nitish-nagesh/contactless-trash-weight-estimator/pictures/IndoorFoodTrash.jpeg

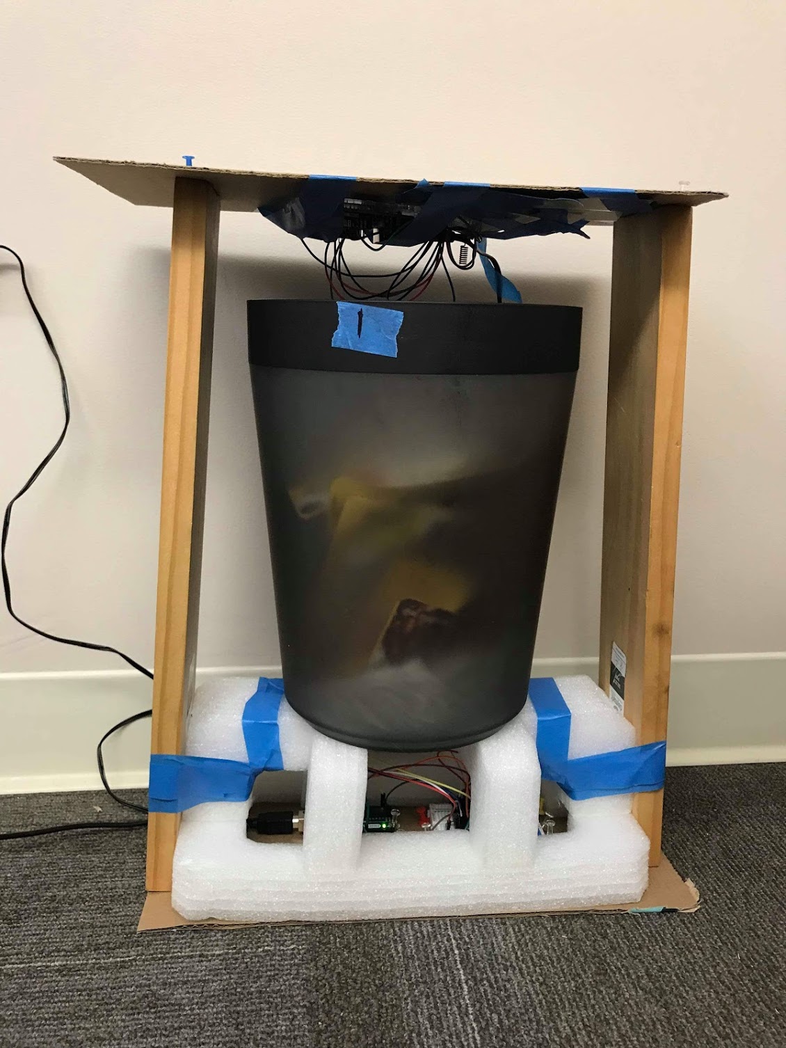
pictures/IndoorFoodTrash.jpeg
