nitish-nagesh/contactless-trash-weight-estimator/pictures/client_server.jpeg

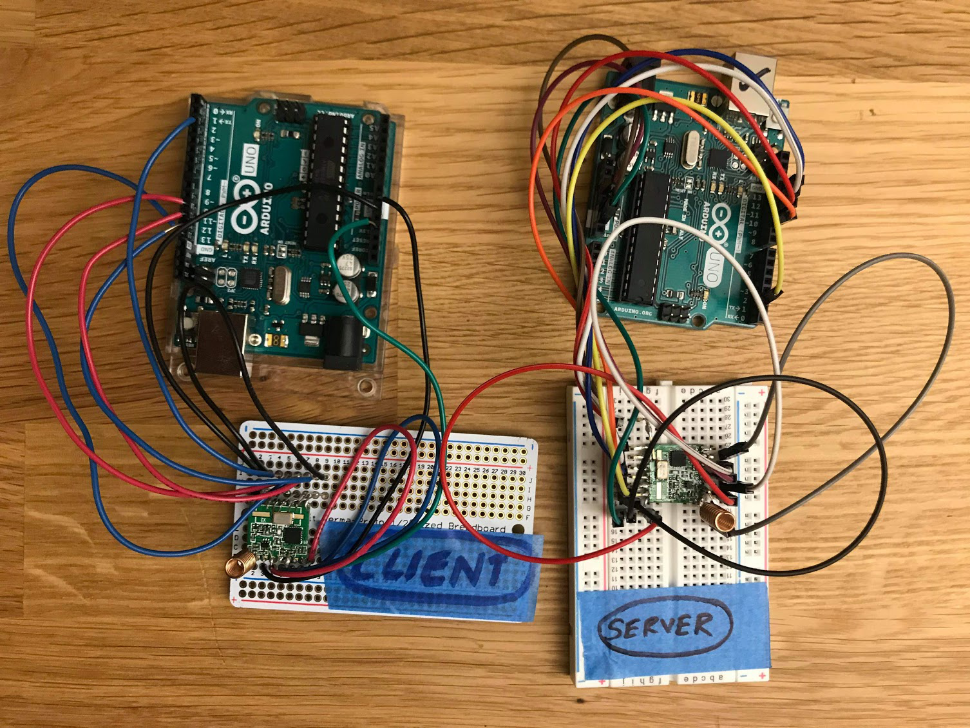
pictures/client_server.jpeg
