nitish-nagesh/contactless-trash-weight-estimator/pictures/FoodWaste.jpeg

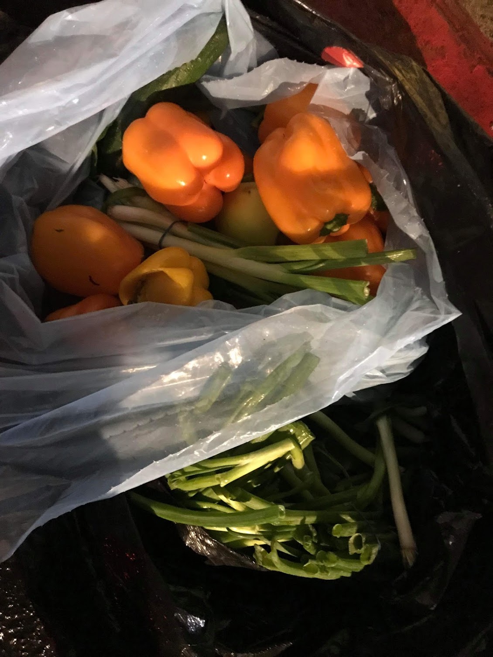
pictures/FoodWaste.jpeg
