nitish-nagesh/contactless-trash-weight-estimator/pictures/IndoorSpaceTrash.jpeg

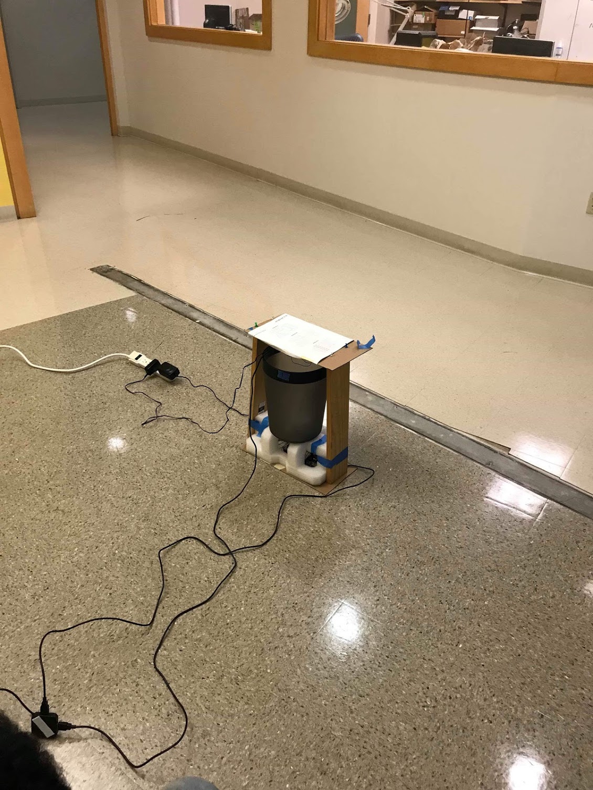
pictures/IndoorSpaceTrash.jpeg
