nitish-nagesh/contactless-trash-weight-estimator/pictures/OutdoorTrashCan.jpeg

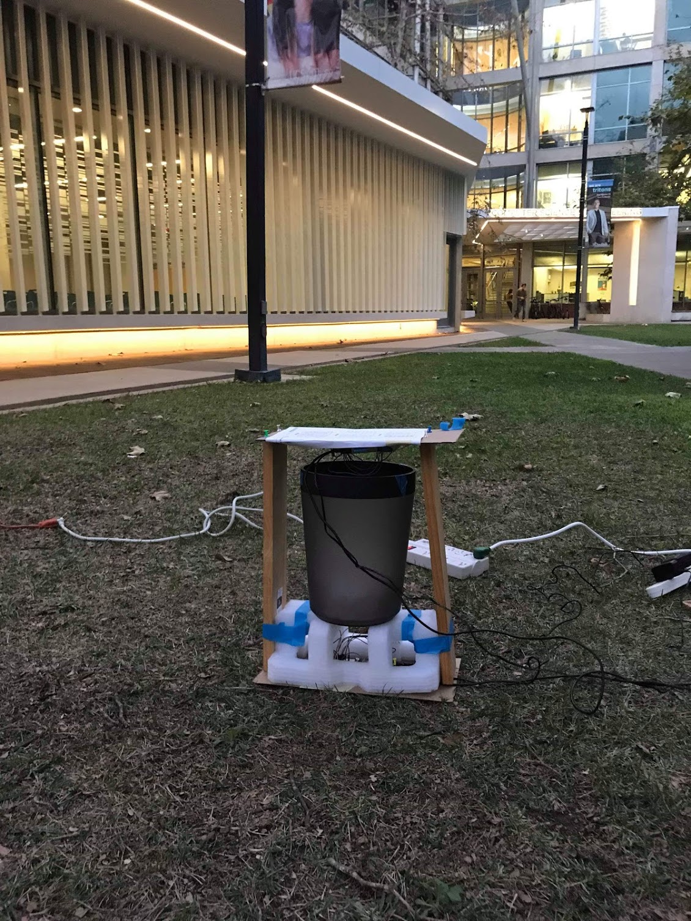
pictures/OutdoorTrashCan.jpeg
