nitish-nagesh/contactless-trash-weight-estimator/pictures/TrashBags.jpeg

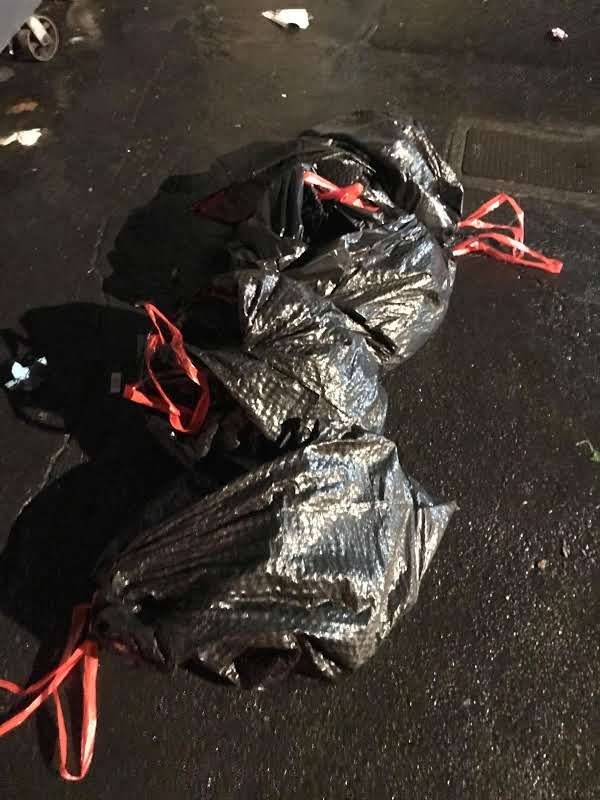
pictures/TrashBags.jpeg
