nitish-nagesh/contactless-trash-weight-estimator/pictures/Mean_Median Comparison Across Materials (1).png

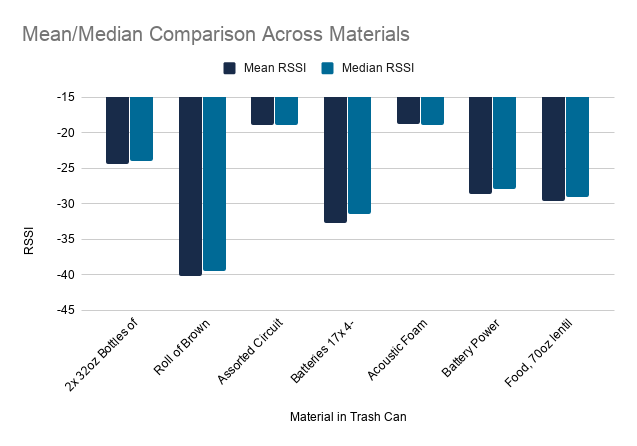
pictures/Mean_Median Comparison Across Materials (1).png
